bablokb/fuchsfalle/doc/Konfiguration.md

Konfiguration
=============

Vorarbeiten
-----------

Zuerst sind einmalig die internen Pullups der GPIOs 17 und 27 zu setzen:

    sudo fuchsctl pullup

Die Einstellung der Uhrzeit erfolgt gemäß dem Dokument
[./RTC.md] (./RTC.md "Real-Time-Clock").

Anpassung der Konfigurationsdatei
---------------------------------

Zwei Dateien müssen angepasst werden. Einmal die Datei `/etc/gammurc`.
Hier muss das richtige Modem-Device eingetragen sein.

Die zweite Konfigurationsdatei ist `/boot/fuchsfalle.cfg` (auf der ersten
Partition des fertig installierten Systems). Hier müssen eine Reihe von
Variablen per Editor angepasst werden:

  - AKTIV="0 oder 1"
  - PIN="Pin-Nummer der SIM-Karte"
  - SMS_NR="SMS-Nummer des Fallenbetreuers"
  - SMS_ADMIN="SMS-Nummer des Systemadministrators"

Die Variable `AKTIV` steuert, ob die Verarbeitung überhaupt anläuft. Die
Variable steht am Anfang auf `0`, damit das System sauber konfiguriert
werden kann. 

Bei `AKTIV=0` fährt das System hoch, setzt GPIO22 auf low und bleibt
hochgefahren, d.h. es wird erst gar nicht versucht, eine SMS zu
senden.

Um besser testen zu können, gibt es die beiden Dateien

  - `/boot/nosend`
  - `/boot/nohalt`

Die Existenz der ersten Datei steuert den SMS-Versand. Solange es die
Datei gibt (Inhalt egal), wird der Versand nicht ausgeführt, sondern
nur simuliert.

Die Existenz der zweiten Datei steuert das Verhalten am Ende der
Verarbeitung. Solange die Datei existiert, fährt das System nicht runter,
man kann sich also auch nach der Verarbeitung anmelden und die
Logmeldungen ansehen. Auch wenn das System nicht runter fährt werden
alle GPIOs entsprechend den Vorgaben gesetzt!

Wichtig: erst mit dem Löschen der beiden Dateien wird das System "scharf" 
geschalten.

Ist die Nummer des Admins leer, werden die Heartbeat-Meldungen auch an
die Nummer des Fallenbetreuers gesendet.

Die Variablen `DEBUG` steuert die Ausgabe von Meldungen ins Systemlog.
Unter produktiven Bedingungen und einem stabilen Betrieb kann die
Variable leer sein (aber sie schadet auch nicht).

Mit der Variablen `ETEST` können Fehlersituationen getestet werden.
Momentan werden die Werte `NOSMS` (simuliert das Fehlschlagen des
SMS-Versands) und `LOOP` (simuliert, dass sich `fuchsfalle.sh` aufhängt)
verwendet.
