bablokb/fuchsfalle/Platinen/README.md

Platinen
========

Dieses Verzeichnis enthält das Platinenlayout der Schaltung sowie
die Bauteilliste mit Preisen (aktuell zum Zeitpunkt der Erstellung).

Die Layouts können mit dem jeweiligen Viewer (Sprint-Layout60_Viewer
und SPLAN-Viewer60) betrachtet und gedruckt werden. Die Viewer gibt
es kostenlos auf der Webseite www.abacom-online.de.
