bablokb/fuchsfalle/Platinen/Fuchsfalle-2-BE.odt

* Bauteilliste zu pi-pic-smd5

aus Datei: "Fuchsfalle-2.lay6"

(31.01.2017 20:30:03)

No Name Value Layer Comment Preis

1 Bu1 BL 2x20G 2,54 1*) 8,5mm Bauhöhe -> 2x BL1x20G 0,54

2 Bu2 PSS 254/2W *) 0,04

3 Bu3 PSS 254/3W *) 0,04

4 C1 X7R-G1206 100N Top SMD 1206 10% 0,04

5 D1 SD103CW Top SMD SOD-123 0,05

6 D2 ZR431FTA Top SMD SOT-23 0,31

7 IC-Bu1 GS 20 Top IC-Fassung DIL Federkont. 0,07

8 PROG1 SL 1x6G 2,54 *) von CSD 0,10

9 R1 100k Top R1-R12: SMD 1206 5% 12x0,03 0,36

10 R2 100k Top

11 R3 10k Top

12 R4 10k Top

13 R5 10k Top

14 R6 1k Top

15 R7 4,7k Top

16 R8 10k Top

17 R9 10k Top

18 R10 22k Top

19 R11 1k Top

20 R12 1M Top

21 T1 IRLML6402 Top SMD SOT-23 0,15

22 T2 IRLML2502 Top SMD SOT-23 0,18

23 T3 IRLML2502 Top SMD SOT-23 0,18

24 Ta1 Taster 3301B *) 0,12

25 IC1 PIC16F690-I/P Top DIl-20 2,10

Gesamt, Euro: 4,28

Außer No1/Bu1 alle BE von der Fa. Reichelt (Value=Bestellnummer)

*) Bauteile auf der Leiterseite montieren (wie SMD) u. löten

1*)Montage von Bestückungsseite, löten auf der Leiterseite

Bauteilliste zu PIC-PI-3

No Name Value Layer Comment Preis

1 Bu1 AKL 383-02 Top SV-Kabel 0,24

2 Bu2 PSS 254/3G Top Steuerkabel 0,02

3 T1 Si4463 *) SMD SO-8 (Darisus GmbH) 0,89

4 R1,2 10k,1M *) SMD 1206 5% 2x0,03 0,06

5 M1 MT3608 Top Boostkonverter 2A 1,00

6 Bathalt HA 1X18650 Top Batteriehalterung für 18650 1,45

7 Sihalt PL 112000 Top 0,18

8 USBKab 722935 Top Micro-USB offenes Ende 0,2m 1,00

9 Kab2pol AKL 369-02 Top für Bu1 0,2m 2x0,5qmm 2x 0,96

10 Zug 1408790 Top Zugentlastung 0,23

11 PI B+ Top Raspberry PI B+ (Pollin) 27,00

Gesamt, Euro: 33,03

Bauteillisten zu Platinen:

PIC-Tester, PI-Tester u. Wartung

No Name Value Layer Comment Preis

PIC-Tester:

1 Bu1 AKL 383-02 Top 0,24

2 IC1 TS 1117 BCW33 *) SMD SOT 0,32

3 DistBu M2,5 10mm Top Bürklin 4x0,20 0,80

4 SL1 SL 2X10G 2,54 Top 0,10

5 SL2-6 SL 1X36G 2,54 Top 0,17

6 Ju1-3 Ju Top 3x0,02 0,06

Summe: 1,69

PI-Tester:

1 Bu1 2x20pol/SMD *) Verbinder zum Pi-Header 1,00

2 LED1-5 versch. Farben Top ge gn or rt bl 1,00

3 SL1-5 SL 1X36G 2,54 Top 0,17

4 DipS NT 02 Top 0,25

Summe: 2,42

Wartung:

1 Bu1 AKL 383-02 Top 0,24

2 Bu2 PSS 254/3G Top 0,02

3 Bu3 Hohl 2,1/5,5 Top 0,30

5 M1 MT3608/XL Top Boostkonverter 2A 1,00

6 Bathalt HA 1X18650 Top Batteriehalterung für 18650 1,45

7 Sihalt PL 112000 Top 0,18

8 Si1 3A flink 5x20 Top 0,20

9 Ju1-5 Ju Top 5x0,02 0,10

10 DistBu M2,0 8mm Top Bürklin 2x0,16 0,32

11 TX1 Adapter Top Eigenbau 1,00

12 LCD 4x16 m. Bel. Top I2C u. Stromquelle 10,00

13,81

Gesamt, Euro: 17,92

Gesamt, S.1-2 55,23
