bablokb/fuchsfalle/Platinen/Fuchsfalle-Schaltung.pdf

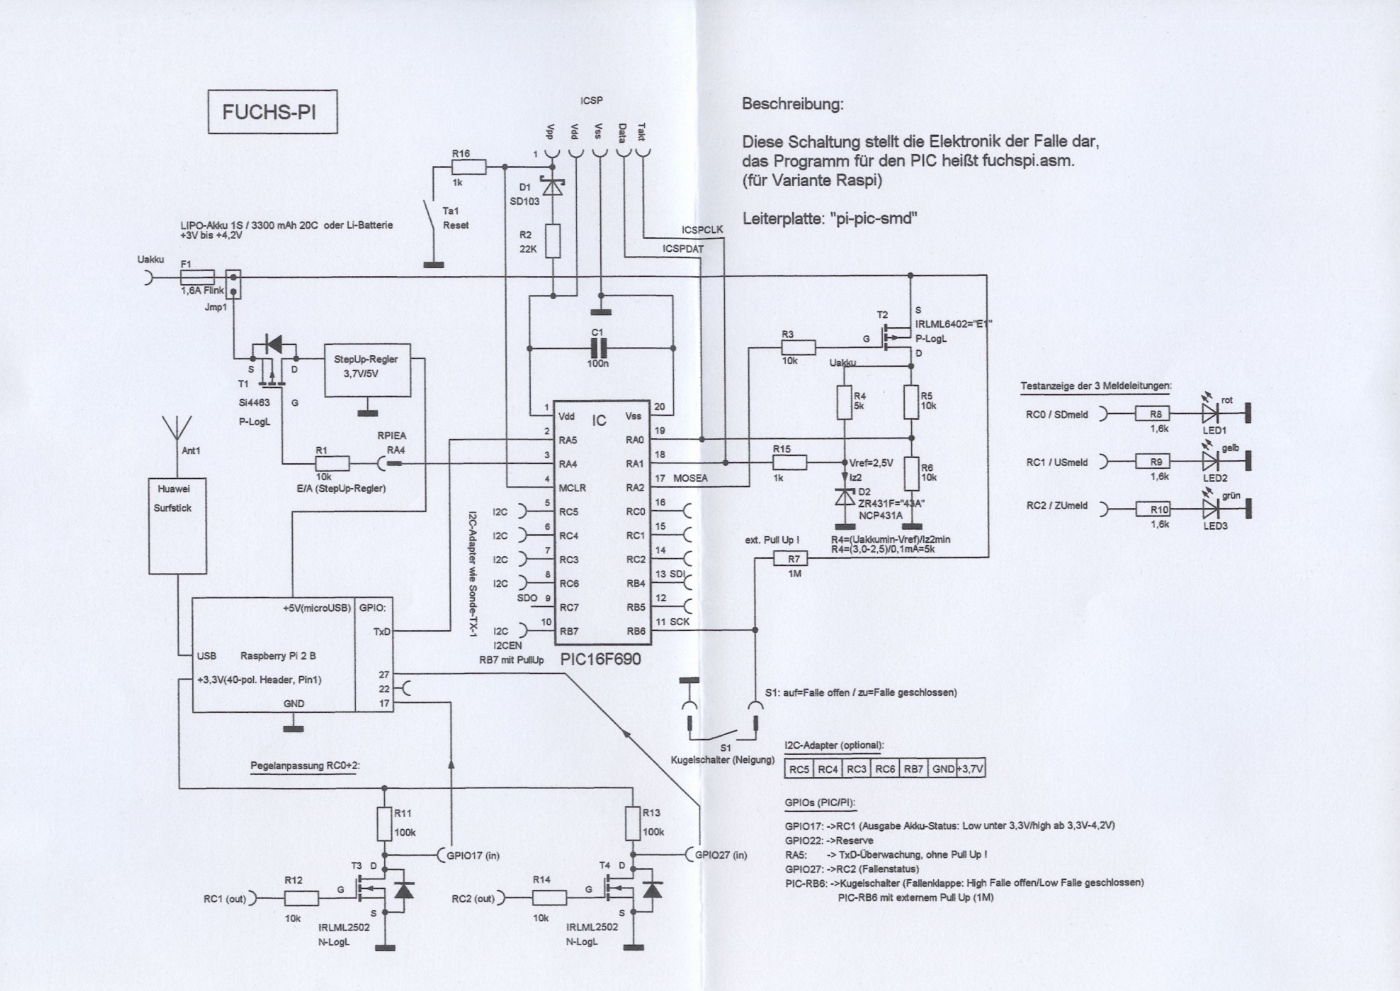
[picture p1: page 1]
