bablokb/fuchsfalle/Assembler/README.md

Assembler
=========

Dieses Verzeichnis enthält die Assemblerprogramme für dieses Projekt.

Für das Projekt ist noch die Standardheaderdatei `P16F690.INC` für
den PIC notwendig. Diese gibt es auf den Seiten des Herstellers
http://www.microchip.com.
