bablokb/fuchsfalle/netinstall/config/post-install.txt

# ---------------------------------------------------------------------------
# Nacharbeiten nach der Installation per RaspberryPi-Netinstaller.
#
# https://github.com/FooDeas/raspberrypi-ua-netinst
#
# Autor: Bernhard Bablok
# Lizenz: GPL3
#
# Website: https://github.com/bablokb/fuchsfalle
#
# ---------------------------------------------------------------------------

# Anpassen /boot/config.txt   -----------------------------------------------

echo "Setze 'max_usb_current=1' in /boot/config/txt ..."
echo -e "\nmax_usb_current=1" >> /rootfs/boot/config.txt

# Systemservice aktivieren   ------------------------------------------------

echo "Aktiviere fuchspower.service ..."
chroot /rootfs /bin/systemctl enable fuchspower.service

# RTC konfigurieren   -------------------------------------------------------

echo "Setze 'dtoverlay=i2c-rtc,ds3231' in /boot/config/txt ..."
echo -e "\ndtoverlay=i2c-rtc,ds3231" >> /rootfs/boot/config.txt
