bablokb/fuchsfalle/(list of files, drawings)

Other design files:
Platinen/Fuchsfalle-RPG.lay6
