bablokb/fuchsfalle/(commit log)

2016-09-17 /boot/nohalt und /etc/rc.local hinzugefügt
2016-09-19 Erste Version
    [fuchsfalle.cfg]
2016-09-19 Definition von MODEM entfernt
    [fuchsfalle.cfg]
2016-09-19 Diverse Korrekturen und Änderungen
2016-09-21 Defaultwert von PIN ist jetzt leer
    [fuchsfalle.cfg]
2016-09-21 Neue Variable SMS_ADMIN
    [fuchsfalle.cfg]
2016-09-21 Zusätzliche Variablen fürs Debugging
    [fuchsfalle.cfg]
2016-09-21 Pin nur setzen, wenn PIN nicht leer
2016-09-21 Zusätzliche Variable AKTIV
    [fuchsfalle.cfg]
2016-09-21 Prüfung, ob AKTIV=1 in der Konfiguration
2016-09-23 Wiederhole setzen der PIN, wenn Timeout aufgetreten ist
2016-10-29 Paketname ist gammu und nicht gammurc
2016-11-02 Meldung 0 und 2 vertauscht
2016-11-08 Programmstart und -ende loggen
2016-11-08 Auslagern Teile der Doku in eigene Dateien
2016-11-19 an neue Struktur des Netinstallers angepasst
2016-12-08 umbenannt wegen Änderungen im Netinstaller
    [installer-config.txt]
2016-12-08 Liste der Packages in Hochkomma setzen
    [installer-config.txt]
2016-12-08 mehr Variable gequotet
    [installer-config.txt]
2016-12-08 Bugfix und manuelle Dateiinstallation
2016-12-09 Paket nano hinzugefügt
    [installer-config.txt]
2016-12-10 Umstieg auf Version 1.5.0 des Netinstallers
2016-12-13 SMS_ADMIN Defaultwert leer
    [fuchsfalle.cfg]
2016-12-16 Umstellen auf WiringPi (gpio)
2016-12-20 Paket wiringpi hinzugefügt
    [installer-config.txt]
2016-12-22 Neue Kommandos powersave/nopowersave
2016-12-22 fuchspower.sh und fuchspower.service aufgenommen
2016-12-22 Variablen fürs Stromsparen eingefügt
    [fuchsfalle.cfg]
2016-12-23 Zusätzlich Paket rfkill aufgenommen
    [installer-config.txt]
2017-01-04 Befehl powerset implementiert
2017-01-07 Paket i2c-tools hinzugefügt
    [installer-config.txt]
2017-01-10 Deaktiviere ntp und fake-hwclock
2017-01-10 Zusätzliches Paket: ntpdate
    [installer-config.txt]
2017-01-10 Beschreibung PS_NOLED angepasst
    [fuchsfalle.cfg]
2017-01-10 LED-Steuerung ausgebaut
2017-01-12 Deaktivieren der Services als erster Schritt
2017-01-12 Option i2c_enable=1 gesetzt
    [installer-config.txt]
2017-01-30 Werte der Stromsparvariablen klargestellt
    [fuchsfalle.cfg]
